Sh4peshifting/2024-nuedc-mspm0/README.md

# 2024NUEDC-MSPM0

#### 介绍
本设计基于LP-MSPM0G3507 设计了单相功率分析仪。该系统通过电流互感器和电压互感器实现对用电插座上负载的电流和电压的测量，系统利用MSPM0内部的程控放大器对信号进行放大， ADC 进行采集， DMA 传输数据，计算实际的电压、电流。通过内置比较器检测信号的过零点，并通过一个周期的积分计算平均值以得出有功功率。同时，系统通过计算电压和电流的均方根值获得视在功率，并进一步计算功率因数。设计使用FFT，用于计算电流谐波系数以及2至10次谐波的有效值。设计与PA测量相对误差绝对值低。
