Sh4peshifting/2024-nuedc-mspm0/doc/figures/circuit.jpg

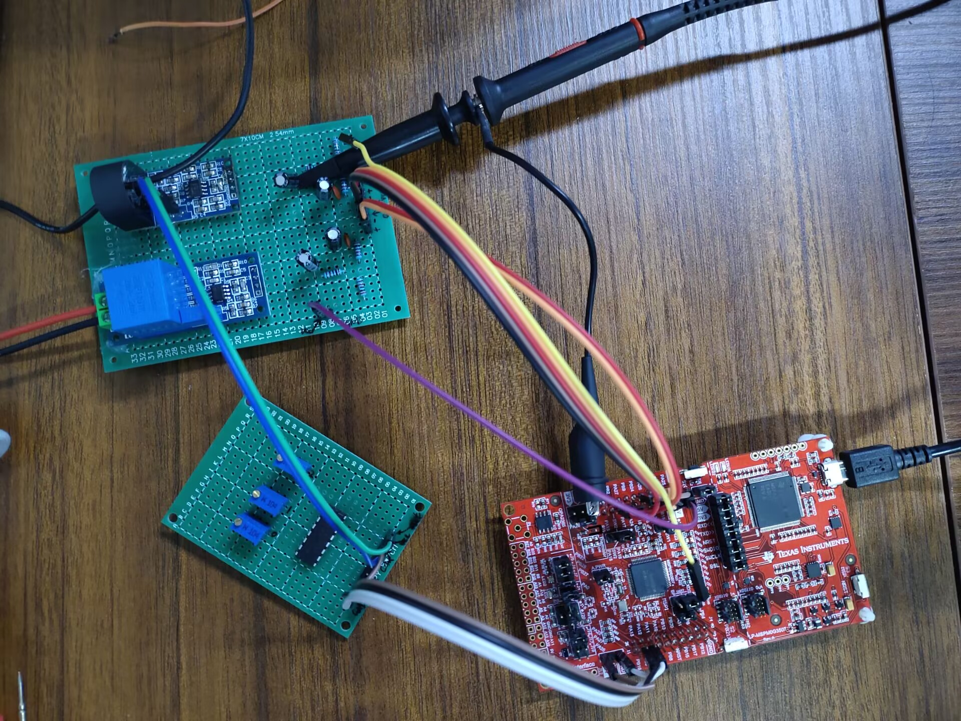
doc/figures/circuit.jpg
