Sh4peshifting/2024-nuedc-mspm0/doc/test.pdf

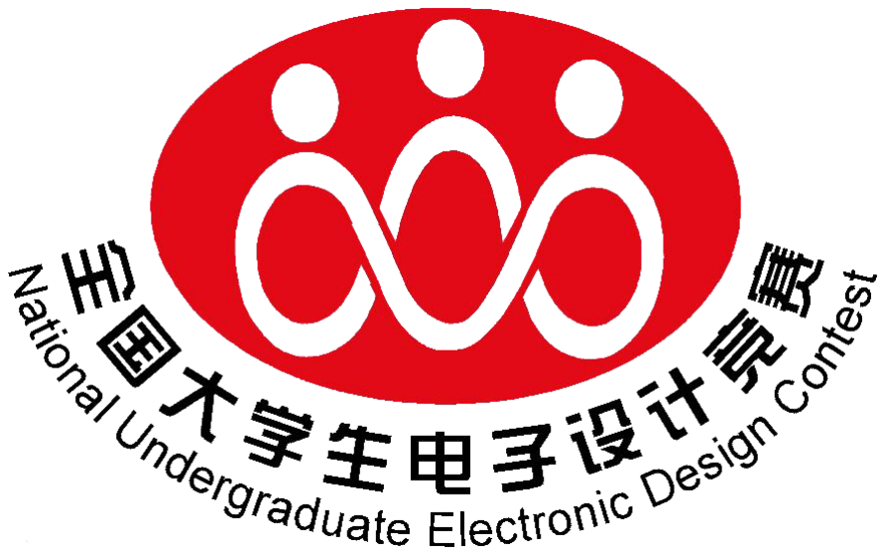
[picture p10: figure]

# 山东省大学生电子设计竞赛设计报告

## 单相功率分析仪（B题）

### 2024 年 8 月 1 日

摘 要

本设计基于 LP-MSPM0G3507 设计了单相功率分析仪。该系统通过电流互感器和 电压互感器实现对用电插座上负载的电流和电压的测量，系统利用 MSPM0 内部的程 控放大器对信号进行放大， ADC 进行采集， DMA 传输数据，计算实际的电压、电 流。通过内置比较器检测信号的过零点，并通过一个周期的积分计算平均值以得出有功 功率。同时，系统通过计算电压和电流的均方根值获得视在功率，并进一步计算功率因 数。设计使用 FFT，用于计算电流谐波系数以及 2 至 10 次谐波的有效值。设计与 PA 测量相对误差绝对值低。此外，系统设计注重低功耗，充分考虑了电气安全规范。本设 计各个模块布局合理，系统稳定性好，制作成本低。
关键词： MSPM0、程控放大器、比较器、FFT、电流谐波系数

目录

A

附

录 | 9

A.1

部

分

程

序

代

码 | 9

A.1.1 FFT

计

算 | 9

A.1.2

交

流

电

参

数

计

算 | 9

A.2

测

试

结

果

图 | 10

## 1 设计任务与要求

基于 TI 公司的微控制器（MCU）芯片，设计并制作一个单相功率分析仪。该 系统需测量用电插座上的负载的电流、电压、有功功率、功率因数、电流总谐波失真 （THD）及 2∼10 次谐波分量的有效值。要求测量精度高，相对误差绝对值：电流、电 压及有功功率⩽ 1%，电流总谐波失真 ⩽ 2%。系统需低功耗，工作功耗⩽ 50mW，且采 用隔离的电流、电压传感测量方案，确保安全。系统由电池供电。

## 2 系统方案设计

## 2.1 设计方案的比较与选择

### 2.1.1 电压互感器方案选型

方案一：电压输出型电压互感器。电压输出型电压互感器采用电力变压器的原理， 在二次侧输出与一次电压成比例的电压信号，用于高阻抗的输入测量设备。不能够输出 大的电流，通常要使用运放提高输出阻抗后采样。
方案二：电流输出型电压互感器。电流输出型电压互感器通常为 1:1 的电流比例， 通过在输入端串联匹配电阻，输出端并联匹配电阻（实际中通常用运放来把电流信号转 化为电压信号）来实现电压的比例的调整，输出阻抗小，而且为电流信号，不容易受到 导线长度的影响。
综合以上两种方案，电流输出型电压互感器输出阻抗小，且能够通过更改匹配电阻 方便的修改电压变比，我们选择方案 2。

### 2.1.2 电流测量增益控制方案选型

方案一：使用模拟开关切换比例放大器反馈电阻。使用比例放大电路来放大电流互 感器模块的信号，通过 CD4051 模拟开关来改变比例放大电路的反馈电阻，实现增益控 制。反馈电阻可以根据应用自行设定。
方案二：使用 MSPM0 片内程控功放。把电流互感器模块输出的电压信号接入到 MSPM0，通过 MSPM0 的外设 OPA 来调整增益，同向放大时增益可以设为 2、4、8、

16、32。
由于要使用更大范围变化的增益，综合以上两种方案，我们选择方案 1。

### 2.1.3 主控板卡的选择

方案一： LP-MSPM0G3507。LP-MSPM0G3507 开发套件是基于 MSPM0G3507 的 易用型评估模块，包含在 MSPM0G3507 M0+ MCU 平台上开始开发所需要的全部资 源，包括用于编程、调试和功率测量的板载调试探针。
方案二：MSPM0L1306 最小系统板。MSPM0L1306 最小系统板体积小，预留调试

器接口，以及一个用户自定义按键，可用于 DIY 设计开发。

方案三：MSP-EXP432E401Y。MSP-EXP432E401Y 开发套件通过集成以太网和一

系列有线通信接口。 MSP432E4 MCU 采用了 120MHz Arm Cortex-M4F CPU、1MB 闪存、256kB SRAM 和先进的加密加速器，为开发人员提供大量的处理资源，从而实 现有线和无线连接栈及处理算法，开发稳健的以太网解决方案。 由于需要使用功耗更低的 MCU，并能够进行功耗分析，综合以上两种方案，我们 选择方案 1。

## 2.2 系统整体设计方案

如图 1 所示。系统包含两个互感器，信号调理电路，LP-MSPM0G3507 开发板，电 源管理模块及电池组成。电压和电流互感器采样到的信号经过信号调理电路进行放大， 滤波之后进入到 MSPM0 内部 ADC 进行采样，同时 MSPM0 可以通过控制增益控制电 路实现自动增益控制。电源管理模块为 MCU 及运放等芯片提供不同的工作电压，同时 优化功耗。

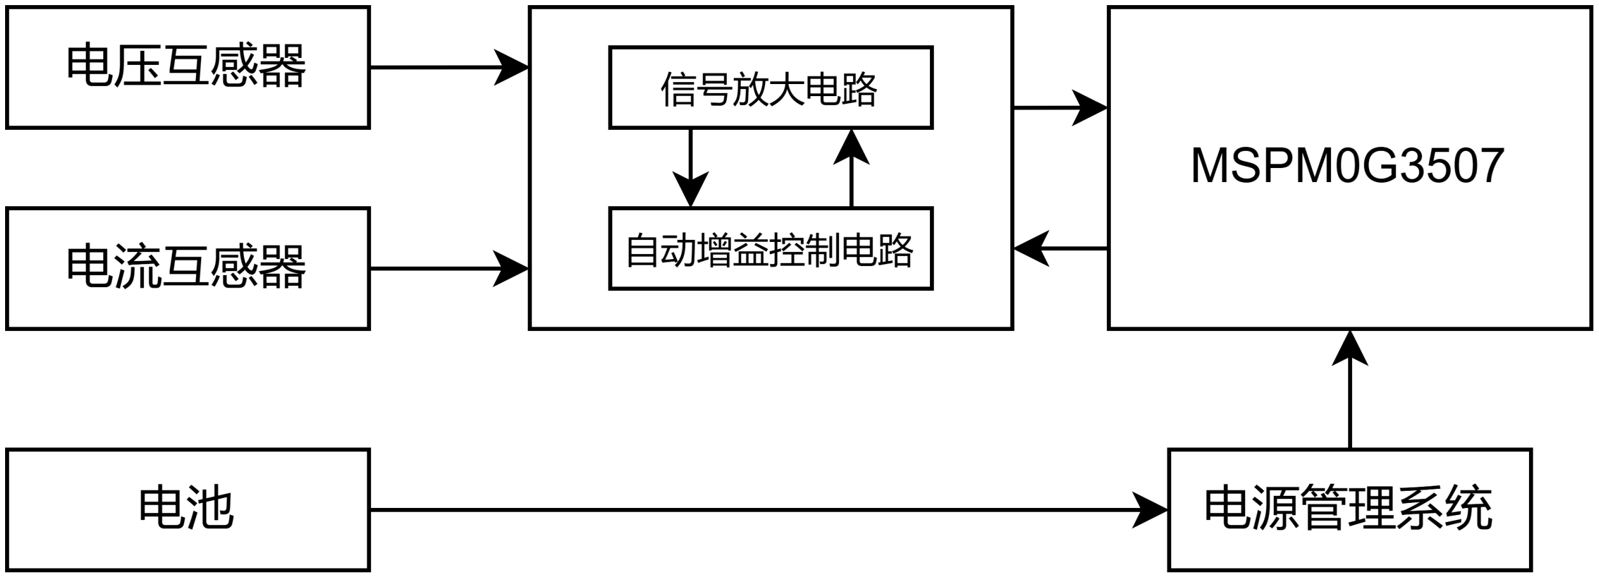
[picture p11: figure]

图 1: 系统结构框图

## 3 系统理论分析与计算

## 3.1 交流电参数的计算方法

电压和电流的采集与转换通过 MSPM0 内部的程控放大器对来自电压互感器和电 流互感器的信号进行放大，确保信号在 ADC 采样范围内。经过放大的电压和电流信号 由 ADC 进行采集。采样频率应合适，以准确捕捉交流信号的波形。然后利用 MSPM0 内部比较器检测电压和电流信号的过零点，以确定信号的周期。这对于后续的功率计算 和 FFT 分析至关重要。

### 3.1.1 有效值计算

对一个完整周期内采集到的电压或电流数据进行平方、求平均值，然后开平方， 如式 1 和式 2 所示，即可得到电压和电流的均方根值（RMS）。

URMS =

### vuut

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
IRMS =

### vuut

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
其中，Ui 和 Ii 分别为采样点的电压和电流值，N 为一个周期内的采样点数。

### 3.1.2 有功功率计算

通过电压和电流的乘积积分计算有功功率。对于一个周期内的功率，积分结果除以 周期得到平均有功功率如式 3 所示。

P =

1
N

X

N

i=1

Ui

- Ii | (3)

### 3.1.3 功率因数计算

功率因数是有功功率与视在功率的比值，如式 4 所示。

P F =

P
S

(4)

视在功率利用电压和电流的RMS值计算，如式 5 所示。

S = URMS · IRMS | (5)

### 3.1.4 谐波分析

对采集的电流信号进行快速傅里叶变换（FFT），提取基波及 2∼10 次谐波的幅值。 通过谐波成分计算电流总谐波失真（THD），如式 6 所示。

T HD =

p
I

2
2 + I

2
3 + · · · + I

2
10
I1

(6)

其中，I1 为基波电流，I2, I3, · · · , I10 为各次谐波电流。

## 3.2 电流互感器工作原理

电流互感器是一种用于测量电流的设备。它通过电磁感应原理将高电流转换为低 电流，以便安全地测量和监控。电流互感器有一次绕组和二次绕组。一次绕组通常由被 测电路的导线直接穿过互感器的中心，形成一个或少数几个匝数。二次绕组则绕在铁芯

上的多匝线圈，通常有很多匝数。当一次绕组中流过电流时，产生一个磁场，这个磁场 在铁芯中产生磁通。磁通在二次绕组中感应出电压，根据法拉第电磁感应定律，二次绕 组中的电压与磁通的变化率成正比。电流互感器的设计使得一次绕组电流与二次绕组 电流之间存在固定的比例关系，称为互感器变比。二次绕组不应在开路状态下工作，因 为开路会导致高电压，可能对设备和人员造成危险。

### 3.3 FFT 原理

快速傅里叶变换（Fast Fourier Transform, FFT）是一种高效计算离散傅里叶变换 （DFT）的方法。 DFT 是将时间域的信号转换为频域信号的数学工具，用于分析信号 的频率成分。
计算 FFT 主要有以下几个步骤：
输入信号的离散化。输入信号在时间上是离散的，即由一组有限的采样点组成。 分解策略。FFT 的核心思想是通过分而治之的方法将 DFT 计算中的重复部分去 除。具体来说，FFT 通过递归地将一个大规模的 DFT 分解成多个小规模的 DFT，这 种分解通常基于信号点数的因子。
蝶形运算。在 FFT 中，最基本的运算单元是“蝶形结构”。蝶形运算将两个点的 运算通过一次加法和一次乘法来完成，极大地减少了计算复杂度。 递归计算。通过不断分解，FFT 将复杂度从原始 DFT 的 O(N²

) 降低到 O(N log N)，
其中 N 是输入信号的采样点数。
输出结果。最终输出是信号在不同频率下的复数幅度，这些复数值包含了信号的频 谱信息，即每个频率成分的幅值和相位。

## 4 电路与程序设计

## 4.1 电路设计

### 4.1.1 电压取样电路

电压取样电路如图 2 所示。该电路主要用于测量交流电压，通过电压互感器将高压 信号降到安全的电平，然后通过一系列的滤波和放大电路，将信号放大到适合后续处理 或测量的电平。运算放大器的使用可以提供所需的增益和信号调理，以确保输出信号的 准确性和稳定性。


图 2: 电压取样电路

### 4.1.2 电流取样电路

电流取样电路如图 3 所示。通过电流互感器将高电流信号转换为小电流信号，再通 过电阻将其转换为电压信号。信号经过两级运算放大器的放大和调理，最终输出适合测 量或处理的电压信号。增益控制模块用于动态调整信号的增益，以适应不同的电流测量 范围。

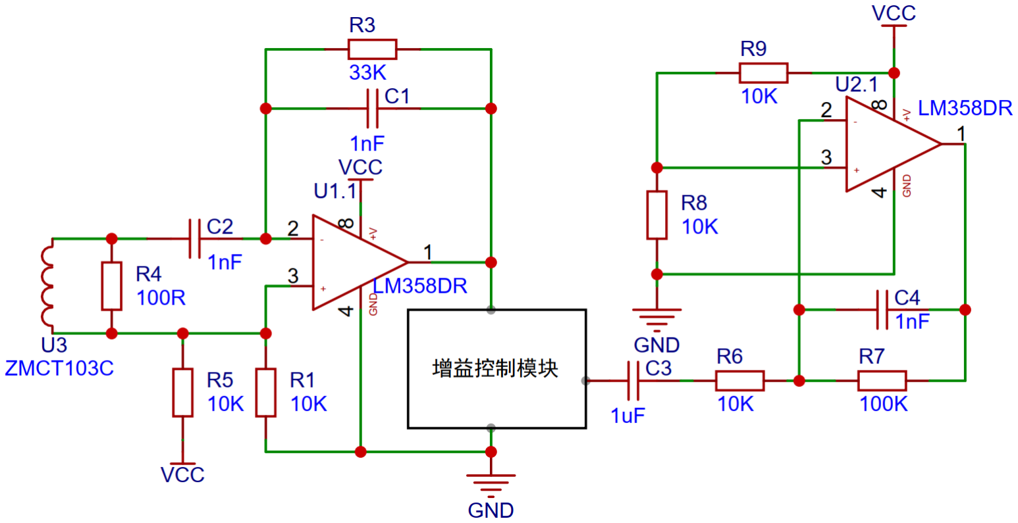
[picture p12: figure]

图 3: 电流取样电路

### 4.1.3 电流增益控制电路

电流增益控制电路如图 4 所示。通过使用模拟多路复用器 (CD4051BE) 和一个运 算放大器 (LM358DR)，实现了输入信号的可控增益。多路复用器允许选择不同的电阻 路径，从而调整输入信号的幅度。然后，运算放大器根据设定的增益放大信号。通过改 变选择信号 (A, B, C)，可以动态调整输入信号的增益。

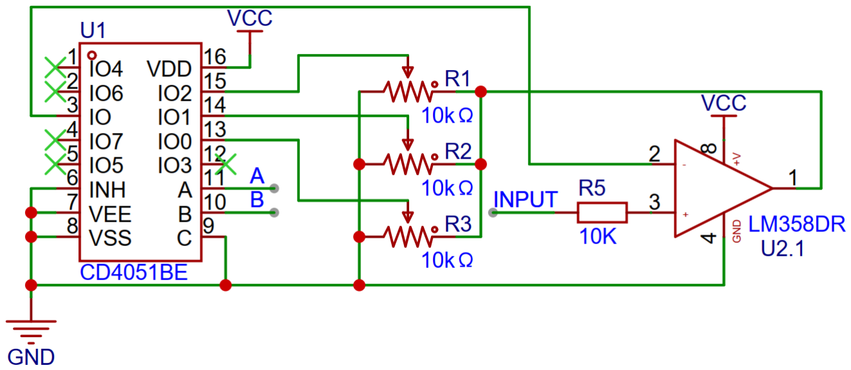
[picture p13: figure]

图 4: 电流增益控制电路

## 4.2 程序设计

### 4.2.1 整体程序工程流程

根据题目要求和设计方案，本文设计了整体程序流程如图 5 所示。


图 5: 整体程序流程图 | 图 6: ADC采样工作流程图

### 4.2.2 ADC采样工作流程

如图 6 所示，ADC采样工作流程主要包括采样、DMA传输等步骤。另外为满足低 功耗要求，系统在空闲时进入低功耗模式，以降低功耗。

### 4.2.3 电流增益自动控制流程

电流增益设计了三个档位，工作时，先根据ADC采样的数据计算峰峰值，峰峰值 与当前档位的高低阈值行进比较，如果超出当前阈值，就根据超出的方向进行增减档 位，如果没有超出阈值，则保持当前档位增益不变。

## 5 系统测试及结果分析

## 5.1 测试方案

为了验证系统的性能是否满足设计要求，本设计采用了以下测试方案，使用功率分 析仪和设计作品同时对电烙铁、电热锅和 LED 灯管进行分析，计算每测量数据并分析 误差。把电压表和电流表接入到作品的供电电路中，在作品工作的过程中记录电压、电 流表的示数，分析作品功耗。测试仪器见表 1。

表 1: 测试仪器

仪器名称 | 型号 | 数量
示波器 | DS2202A | 1
功率分析仪 | TA3331 | 1
万用表 | ZT102A | 2

表 2: 测试结果

测试负载 | URMS | IRMS | P | P F | T HD

电烙铁

功率分析仪 223.1V | 150mA | 33.35W | 0.997 | 6.9%
设计作品 | 223.2V | 149mA | 33.16W | 0.997 | 7.0%
误差 | 0.04% | 0.6% | 0.5% | 0% | 1.4%

电热锅

功率分析仪 222.9V | 2.21A | 492.11W | 0.999 | 1.1%
设计作品 | 223.0V | 2.23A | 496.29W | 0.998 | 1.1%
误差 | 0.04% | 0.9% | 0.02% | 0.01% | 0%

LED 灯管

功率分析仪 223.6V 101.33mA | 18.76W | 0.828 | 8.5%
设计作品 | 223.4V 102.01mA | 18.68W | 0.819 | 8.3%
误差 | 0.08% | 0.06% | 0.04% | 1% | 2%

## 5.2 测试结果及分析

系统的性能经过测试，和成品功率分析仪相比，具有较高的精度；工作状态下的功 耗仅为 42mW，功耗较低，满足题目需求，测试结果见表 2 及附录图 A.2。

## 6 结论

在本次大赛中，我们使用 MSPM0 设计了一个高精度、低功耗的功率分析仪，能够 对交流负载的各种电参数进行分析，满足题目的需求。同时，我们充分发挥了 MSPM0 MCU 的优势，使用了片内运放、比较器等模拟外设，简化了外部电路。我们通过降低 主频、关闭无用外设、休眠 CPU 等方式，有效的降低了系统功耗。同时，由于比赛时 间紧，任务多，我们的作品还有很多值得改进的地方，比如用户操作逻辑还可以进一步 优化，功耗还能进一步降低。这些都是值得探索的方向。本次比赛，我们学到了许多知 识，激发了我们对于电子的热爱，将引导我们在这个方向上进一步钻研，为以后的学习 铺下道路。

## 参考文献

[1] 华成英. 模拟电子技术[M]. 高等教育出版社, 2022.
[2] 邱关源, 罗先觉. 电路[M]. 高等教育出版社, 2022.
[3] 王兆安. 电力电子技术[M]. 机械工业出版社, 2011.
[4] OPPENHEIM A V. 数字信号处理[M]. 电子工业出版社, 2020.

## A 附录

A.1 | 部分程序代码
A.1.1 | FFT 计算 ✞ | ☎
1 | void fft_proc(float *input_signal)
2 | {
3 | float input_cmplx[2048]={0};
4 | for (uint16_t i = 0; i < 1024; i++){
5 | input_cmplx[2*i] = input_signal[i]*hamming[i];
6 | }

7

8 | arm_cfft_f32(&arm_cfft_sR_f32_len1024 , input_cmplx , 0 , 1);
9 | arm_cmplx_mag_f32(input_cmplx,volt,1024);

10

11 | uint16_t base_wave_index=find_max_index(volt,3,20);
12 | harmonic[1]=find_max(volt,3,20)/512;
13 | for(uint16_t i=2;i<16;i++){
14 | harmonic[i]= find_max(volt, base_wave_index*i-3, base_wave_index*i
| +3) / 512;
15 | }
16 | curr_thd_calc();
17 | }

✝

A.1.2 | 交流电参数计算 ✞ | ☎
1 | static void adc_data_calc_input()
2 | {
3 | for (uint16_t i = 0; i < RESULT_SIZE ; i++) {
4 | volt[i] = volt[i]*VOLT_COEF;
5 | curr[i] = curr[i]*gain_coef[current_range]/COIL_N;
6 | }

7

8 | arm_rms_f32(volt+volt_edge_inx[0], volt_edge_inx[volt_edge_rec-1]-
| volt_edge_inx[0]+1, &volt_rms);

✝

✞ | ☎
9 | arm_rms_f32(curr+volt_edge_inx[0], volt_edge_inx[volt_edge_rec-1]- volt_edge_inx[0]+1, &curr_rms);

10

11 | AP=power_calc();
12 | PF= AP/(volt_rms*curr_rms);
13 | }

✝

## A.2 测试结果图


图 7: ADC 采样结果


图 8: FFT 分析结果
