Sh4peshifting/2024-nuedc-mspm0/mspm0-proj/empty.c

/*
 * Copyright (c) 2021, Texas Instruments Incorporated
 * All rights reserved.
 *
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
 * *  Redistributions of source code must retain the above copyright
 *    notice, this list of conditions and the following disclaimer.
 *
 * *  Redistributions in binary form must reproduce the above copyright
 *    notice, this list of conditions and the following disclaimer in the
 *    documentation and/or other materials provided with the distribution.
 *
 * *  Neither the name of Texas Instruments Incorporated nor the names of
 *    its contributors may be used to endorse or promote products derived
 *    from this software without specific prior written permission.
 *
 * THIS SOFTWARE IS PROVIDED BY THE COPYRIGHT HOLDERS AND CONTRIBUTORS "AS IS"
 * AND ANY EXPRESS OR IMPLIED WARRANTIES, INCLUDING, BUT NOT LIMITED TO,
 * THE IMPLIED WARRANTIES OF MERCHANTABILITY AND FITNESS FOR A PARTICULAR
 * PURPOSE ARE DISCLAIMED. IN NO EVENT SHALL THE COPYRIGHT OWNER OR
 * CONTRIBUTORS BE LIABLE FOR ANY DIRECT, INDIRECT, INCIDENTAL, SPECIAL,
 * EXEMPLARY, OR CONSEQUENTIAL DAMAGES (INCLUDING, BUT NOT LIMITED TO,
 * PROCUREMENT OF SUBSTITUTE GOODS OR SERVICES; LOSS OF USE, DATA, OR PROFITS;
 * OR BUSINESS INTERRUPTION) HOWEVER CAUSED AND ON ANY THEORY OF LIABILITY,
 * WHETHER IN CONTRACT, STRICT LIABILITY, OR TORT (INCLUDING NEGLIGENCE OR
 * OTHERWISE) ARISING IN ANY WAY OUT OF THE USE OF THIS SOFTWARE,
 * EVEN IF ADVISED OF THE POSSIBILITY OF SUCH DAMAGE.
 */

#include "ti_msp_dl_config.h"
#include "adc_data_conv.h"
#include "fft.h"
#include "timer.h"
#include "screen_driver.h"

extern uint8_t page;


int main(void)
{
    SYSCFG_DL_init();
    DL_SYSCTL_setPowerPolicyRUN0SLEEP0();

    adc_dma_init();

    NVIC_EnableIRQ(BUTTON_GPIOA_INT_IRQN);
    NVIC_EnableIRQ(BUTTON_GPIOB_INT_IRQN);

    DL_COMP_enable(COMP_0_INST);
    NVIC_EnableIRQ(TIMER_0_INST_INT_IRQN);
    
    screen_init();
    while (1) {
        adc_data_opt();
        // while (DL_GPIO_readPins(GPIO_SWITCHES_PORT, GPIO_SWITCHES_USER_SWITCH_1_PIN));
        disp_proc();
        
   
    }
}
