Sh4peshifting/2024-nuedc-mspm0/mspm0-proj/screen/screen_driver.h

#ifndef __SCREEN_DRIVER_H__
#define __SCREEN_DRIVER_H__

#include "ti_msp_dl_config.h"


#define WR_CD_PIN(level) if(level == 0) \
                            DL_GPIO_clearPins(SPI_CD_PORT, SPI_CD_PIN); \
                          else  \
                            DL_GPIO_setPins(SPI_CD_PORT, SPI_CD_PIN)
#define WR_CS_PIN(level) if(level == 0) \
                            DL_GPIO_clearPins(SPI_CS_PORT, SPI_CS_PIN); \
                          else  \
                            DL_GPIO_setPins(SPI_CS_PORT, SPI_CS_PIN)
#define WR_RST_PIN(level) if(level == 0) \
                            DL_GPIO_clearPins(SPI_RST_PORT, SPI_RST_PIN); \
                          else  \
                            DL_GPIO_setPins(SPI_RST_PORT, SPI_RST_PIN)

#define CLR_SCREEN display(0x00, 0x00)

void delay_ms(uint16_t ms);
void screen_init(void);
void disp_str_ascii(uint8_t uc_RowNo, uint8_t uc_ColNo, uint8_t *ptr, uint8_t uc_Cnt);

#endif
