Sh4peshifting/2024-nuedc-mspm0/mspm0-proj/adc_data_proc/fft.c

#include "fft.h"
#include "arm_const_structs.h"
#include "arm_math.h"
#include <stdio.h>

// float current_spectrum[2048];
float harmonic[16];
//frequency increasement 4.88Hz
float curr_thd;

const float hamming[] = {
    0.080000013113021851, 0.080008685588836670, 0.080034643411636353,
    0.080077946186065674, 0.080138564109802246, 0.080216467380523682,
    0.080311715602874756, 0.080424249172210693, 0.080554097890853882,
    0.080701261758804321, 0.080865681171417236, 0.081047415733337402,
    0.081246405839920044, 0.081462681293487549, 0.081696212291717529,
    0.081946998834609985, 0.082215040922164917, 0.082500308752059937,
    0.082802802324295044, 0.083122521638870239, 0.083459407091140747,
    0.083813518285751343, 0.084184795618057251, 0.084573239088058472,
    0.084978818893432617, 0.085401535034179688, 0.085841357707977295,
    0.086298286914825439, 0.086772292852401733, 0.087263375520706177,
    0.087771505117416382, 0.088296622037887573, 0.088838785886764526,
    0.089397907257080078, 0.089974015951156616, 0.090567082166671753,
    0.091177046298980713, 0.091803908348083496, 0.092447638511657715,
    0.093108206987380981, 0.093785643577575684, 0.094479858875274658,
    0.095190852880477905, 0.095918565988540649, 0.096663028001785278,
    0.097424149513244629, 0.098201990127563477, 0.098996430635452271,
    0.099807441234588623, 0.100635081529617310, 0.101479232311248779,
    0.102339893579483032, 0.103217065334320068, 0.104110658168792725,
    0.105020642280578613, 0.105947017669677734, 0.106889754533767700,
    0.107848793268203735, 0.108824074268341064, 0.109815597534179688,
    0.110823303461074829, 0.111847221851348877, 0.112887233495712280,
    0.113943308591842651, 0.115015447139739990, 0.116103559732437134,
    0.117207646369934082, 0.118327647447586060, 0.119463533163070679,
    0.120615243911743164, 0.121782749891281128, 0.122965991497039795,
    0.124164938926696777, 0.125379562377929688, 0.126609742641448975,
    0.127855539321899414, 0.129116833209991455, 0.130393594503402710,
    0.131685793399810791, 0.132993340492248535, 0.134316235780715942,
    0.135654389858245850, 0.137007772922515869, 0.138376325368881226,
    0.139760017395019531, 0.141158759593963623, 0.142572492361068726,
    0.144001245498657227, 0.145444869995117188, 0.146903336048126221,
    0.148376613855361938, 0.149864673614501953, 0.151367366313934326,
    0.152884721755981445, 0.154416650533676147, 0.155963122844696045,
    0.157523989677429199, 0.159099310636520386, 0.160688936710357666,
    0.162292867898941040, 0.163911014795303345, 0.165543317794799805,
    0.167189717292785645, 0.168850123882293701, 0.170524567365646362,
    0.172212868928909302, 0.173915028572082520, 0.175630986690521240,
    0.177360653877258301, 0.179103970527648926, 0.180860906839370728,
    0.182631343603134155, 0.184415221214294434, 0.186212480068206787,
    0.188023090362548828, 0.189846932888031006, 0.191683948040008545,
    0.193534076213836670, 0.195397287607192993, 0.197273433208465576,
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
    };
    
float find_max(float *array,uint16_t start,uint16_t end)
{
    float max_value=0;
    uint16_t max_index=0;
    for(uint16_t i=start;i<end;i++){
        if(array[i]>max_value ){
            max_value=array[i];
            max_index=i;
        }
    }
    return max_value+array[max_index-1]+array[max_index+1];
}

uint16_t find_max_index(float *array,uint16_t start,uint16_t end)
{
    float max_value=0;
    uint16_t max_index=0;
    for(uint16_t i=start;i<end;i++){
        if(array[i]>max_value ){
            max_value=array[i];
            max_index=i;
        }
    }
    return max_index;
}

void curr_thd_calc()
{
    float curr_pow_sum = 0;
    float curr_sqrt = 0;
    arm_power_f32(harmonic+2, 14, &curr_pow_sum);
    arm_sqrt_f32(curr_pow_sum, &curr_sqrt);

    curr_thd = curr_sqrt / harmonic[1];

}

// void arm_hamming_f32(
//         float32_t * pDst,
//         uint32_t blockSize)
// {
//    float32_t k = 2.0f / ((float32_t) blockSize);
//    float32_t w;

//    for(uint32_t i=0;i<blockSize;i++)
//    {
//      w = 0.54f - 0.46f * cosf (PI * i * k);
//      pDst[i] = w;
//    }
// }

void fft_proc(float *input_signal)
{
    float input_cmplx[2048]={0};
    for (uint16_t i = 0; i < 1024; i++){
        input_cmplx[2*i] = input_signal[i]*hamming[i];
    }
    
    arm_cfft_f32(&arm_cfft_sR_f32_len1024 , input_cmplx , 0 , 1);
    arm_cmplx_mag_f32(input_cmplx,volt,1024);

    uint16_t base_wave_index=find_max_index(volt,3,20);
    // harmonic[1]=find_max(volt,3,20)/512/1.41421;
    for(uint16_t i=1;i<16;i++){
       harmonic[i]= find_max(volt, base_wave_index*i-3, base_wave_index*i+3) / 512 /1.41421;
    }
    curr_thd_calc();
}
