Sh4peshifting/2024-nuedc-mspm0/(commit log)

2024-07-24 feat: Update timer function
2024-07-29 add timer interrupt
2024-07-29 feat: add volt_rms calc
2024-07-30 fix array out of range when calc spectrum
    [fft.c, fft.h]
2024-07-30 chore: decrease adc sample num
2024-07-31 change adc proc function
2024-07-31 feat: add screen driver and external gain adjust
2024-07-31 change adc data proc theory
2024-07-31 feat: add power calc
2024-08-01 add range auto select and calibration data
2024-08-01 fix screen function and add display ascii support
    [screen_driver.c]
2024-08-02 feat: add button function
2024-08-02 chore: change button pins
2024-08-02 fix: fix disp bugs and comp bugs
    [adc_data_conv.c, adc_data_conv.h, disp.c, empty.c]
